Xinyuan-LilyGO/T-FPGA/dimensions/README.MD

# [PCB 3D](./pcb3d/FPGA-CORE.7z)



# [CORE SIZE](./dxf/FPGA-CORE.dwg)
