Xinyuan-LilyGO/T-FPGA/example/FPGA/i2c-slave/impl/gwsynthesis/i2c-slave_syn_resource.html

# Hierarchy Module Resource

MODULE NAME | REG NUMBER | ALU NUMBER | LUT NUMBER | DSP NUMBER | BSRAM NUMBER | SSRAM NUMBER
i2c (D:/File/Micky/Github/T-FPGA/example/FPGA/i2c-slave/i2c-slave/src/i2c.v) | - | - | 3 | - | - | -
|--slave (D:/File/Micky/Github/T-FPGA/example/FPGA/i2c-slave/i2c-slave/src/i2c.v) | 19 | - | 31 | - | - | -
