Xinyuan-LilyGO/T-FPGA/example/FPGA/spi-blink/impl/gwsynthesis/spi-blink_syn_resource.html

# Hierarchy Module Resource

MODULE NAME | REG NUMBER | ALU NUMBER | LUT NUMBER | DSP NUMBER | BSRAM NUMBER | SSRAM NUMBER
spi_top (D:/File/Micky/Github/T-FPGA/example/FPGA/spi-blink/src/spi-top.v) | 9 | 7 | 3 | - | - | -
|--osc (D:/File/Micky/Github/T-FPGA/example/FPGA/spi-blink/src/spi-top.v) | - | - | - | - | - | -
|--pll (D:/File/Micky/Github/T-FPGA/example/FPGA/spi-blink/src/spi-top.v) | - | - | - | - | - | -
|--spi_slaver1 (D:/File/Micky/Github/T-FPGA/example/FPGA/spi-blink/src/spi-top.v) | 28 | - | 24 | - | - | -
