Xinyuan-LilyGO/T-FPGA/image/6.png

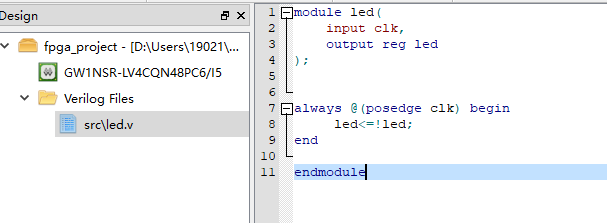
image/6.png
