Xinyuan-LilyGO/T-FPGA/(list of files, cad)

Other CAD files:
dimensions/dxf/FPGA-CORE.dwg
