Xinyuan-LilyGO/T-FPGA/(threads)

Thread 4 (2023-09-06):

Buttons incorrectly labled?

Ebiroll, 2023-09-06:
I tried to follow the instruction for the led program, but I used GOWIN version 1.9.8.11
I could not get the program to work properly so I flashed the precompiled turn_on_power S3 program. (from zip file)

I did this as I was not able to compile the S3 program with platform IO https://github.com/platformio/platform-espressif32/tags

Now it seems to work with lots of random blinking, (as expected)

However the GPIO0 button works but not the IOT13B button.
I also think I was able to set S3 into boot mode with the IOT13B  that is on the bottom to the right.
Is the buttons labeled incorrectly? Could you provide the correct labels of the 4 buttons?

Ebiroll, 2023-09-06:
Yes, the buttons are incorrectly labeled, https://github.com/Xinyuan-LilyGO/T-FPGA

Closed 2023-09-06.

Thread 6 (2023-10-31):

M.2 (Key B) common pinout incompatibility?

vrbadev, 2023-10-31:
From the M.2 Key B interface pinout in the schematic, I assume the interface is not used [in compliance with the M.2 interfaces](https://www.congatec.com/fileadmin/user_upload/Documents/Application_Notes/AN43_M.2_Pinout_Descriptions_and_Reference_Designs.pdf) common on motherboards.
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
Is my understanding correct that the board, in fact, can't be used in the common M.2 slot?

Thread 7 (2024-03-17):

Pin Voltage

carlosgblos, 2024-03-17:
I'm usinng the T-FPGA with the expansion kit. The PMODs are strange related to the voltage. The P6 and P8 on the VCC only provides 1.8V, the P3 and P5 I have 0V, even using the pins from that bank.

I already changed the ESP32 code to provide 3.3V to the banks, and still cannot get the proper voltage.

What am I doing wrong ?

Thread 9 (2024-09-21):

Unable to program FPGA on Linux Mint

ChrisJones79, 2024-09-21:
I read through the README and was able to upload the 'turn_on_power' project to the ESP32. I see the LEDs behaving appropriately and saw that the terminal in platformio reported a successful programming. Now, I have opened the Gowin IDE and all has compiled (it was already) and the programmer opens, as expected.

Here is the log from the programmer, while trying to upload to the FPGA. I do have the USB-C connected to the FPGA-JTAG port, too.

```
Info:	Cable found:  Gowin USB Cable(GWU2X)/0/17/null (USB location:17)
Info:	Cost 0.02 second(s)
:
Info:	Cable found:  Gowin USB Cable(GWU2X)/0/17/null (USB location:17)
Info:	Cost 0.01 second(s)
:
Info:	Target Cable: Gowin USB Cable(GWU2X)/0/17/null@1.33 MHz
Info:	Target Device: GW1NSR-4C(0x0100981B)
Info:	Operation "SRAM Program" for device#1...
Error:	Cable open failed.
Info:	Cost 0.0 second(s)
:
Info:	Target Cable: Gowin USB Cable(GWU2X)/0/17/null@1.33 MHz
Info:	Target Device: GW1NSR-4C(0x0100981B)
Info:	Operation "SRAM Program" for device#1...
Error:	Cable open failed.
Info:	Cost 0.0 second(s)
:
Info:	Scanning!
Info:	Target Cable: Gowin USB Cable(GWU2X)/0/17/null@1.33 MHz
Error:	Cable open failed.
Error:	No Gowin devices found!
Info:	Cost 0.02 second(s)
```

Also:
```
$ lsusb
Bus 001 Device 037: ID 33aa:0120 GOWINSEMI GWU2X
```

and plugging in while udev monitoring:

```
$ udevadm monitor
KERNEL[675634.337777] add      /devices/pci0000:00/0000:00:14.0/usb1/1-2 (usb)
KERNEL[675634.339741] add      /devices/pci0000:00/0000:00:14.0/usb1/1-2/1-2:1.0 (usb)
KERNEL[675634.339944] bind     /devices/pci0000:00/0000:00:14.0/usb1/1-2 (usb)
UDEV  [675634.376606] add      /devices/pci0000:00/0000:00:14.0/usb1/1-2 (usb)
UDEV  [675634.378558] add      /devices/pci0000:00/0000:00:14.0/usb1/1-2/1-2:1.0 (usb)
UDEV  [675634.383025] bind     /devices/pci0000:00/0000:00:14.0/usb1/1-2 (usb)

```

I don't have any `udev` rules added for the T-FPGA, and I didn't see anywhere in the repo where the rules would be.

Here's a screenshot from the programmer:
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

Any help? Thanks.

Thread 10 (2025-05-04):

ERROR  (CT1136) : Bank 3 vccio(1.8) is locked by other constraint or embedded port, conflicting BANK_VCCIO set by 'led_state_obuf' : IO_TYPE = LVCMOS33 in the same bank

juthi, 2025-05-04:
"led_state" is on BANK3. BANK3 on this FPGA device is also mated with HyperRam so VIO is fixed to 1v8.

Therefore,
IO_PORT "led_state" IO_TYPE=LVCMOS33 PULL_MODE=NONE DRIVE=8; // will raise an error with the latest toolchains from Gowin.

Fix:

IO_PORT "led_state" IO_TYPE=LVCMOS**_18_** PULL_MODE=NONE DRIVE=8;
