Xinyuan-LilyGO/T-FPGA/schematic/T-FPGA-V1.0 CORE.pdf

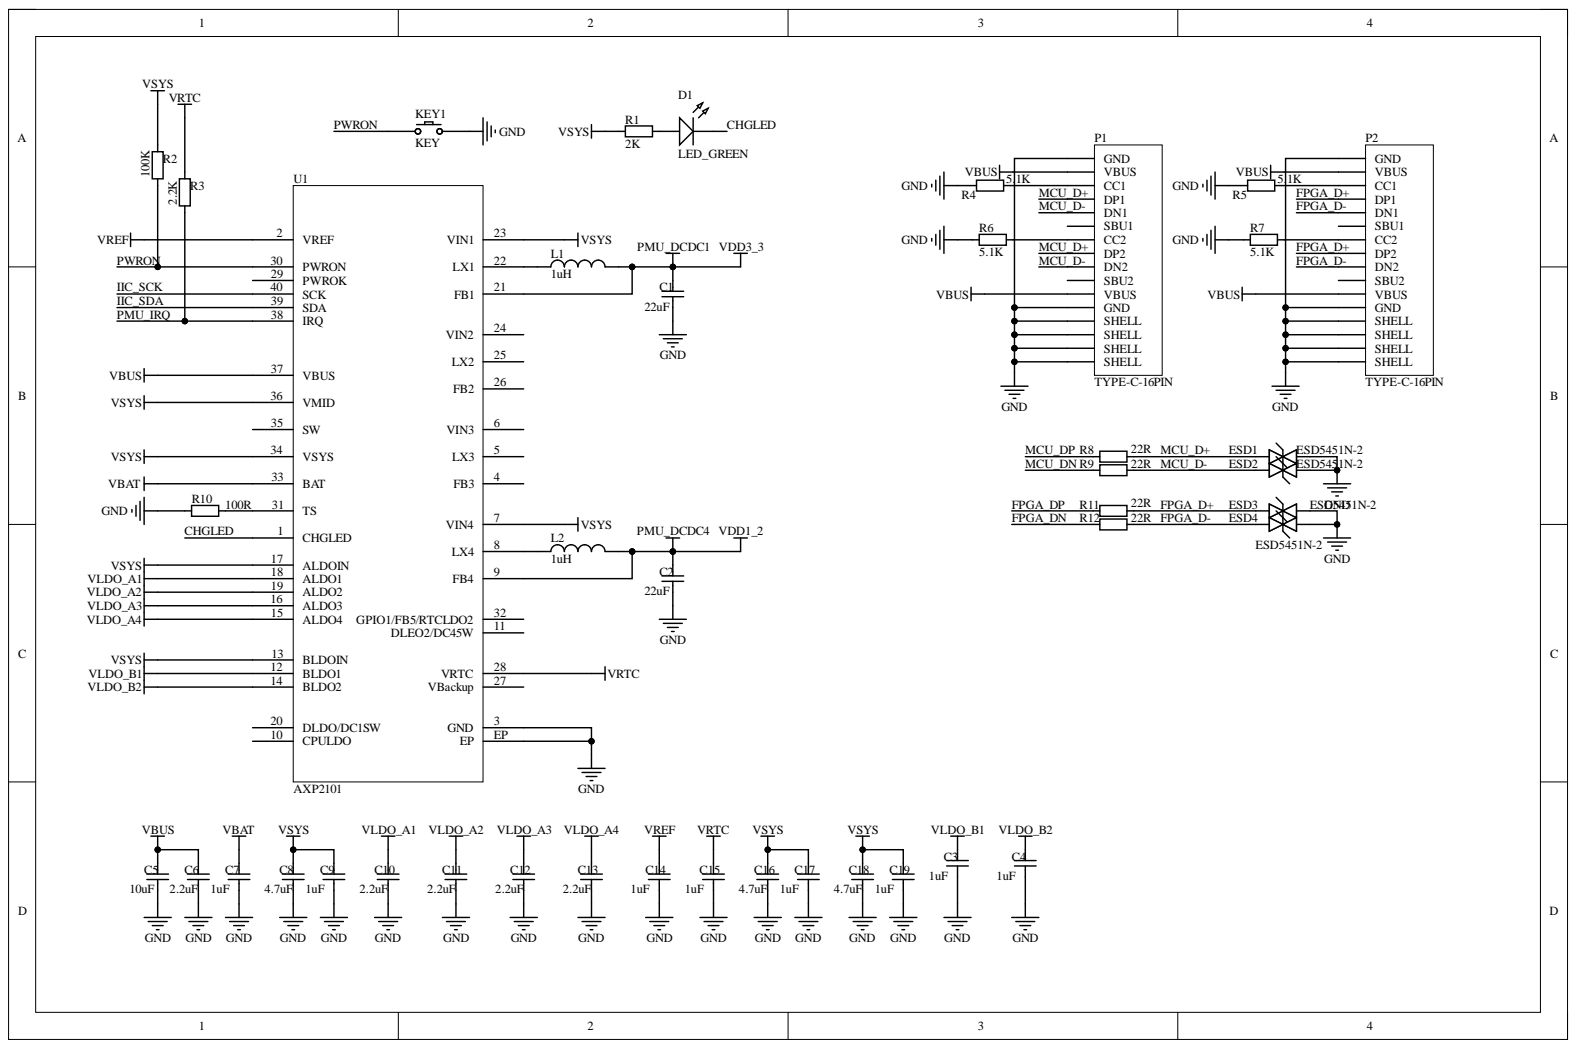
[picture p21: page 1]

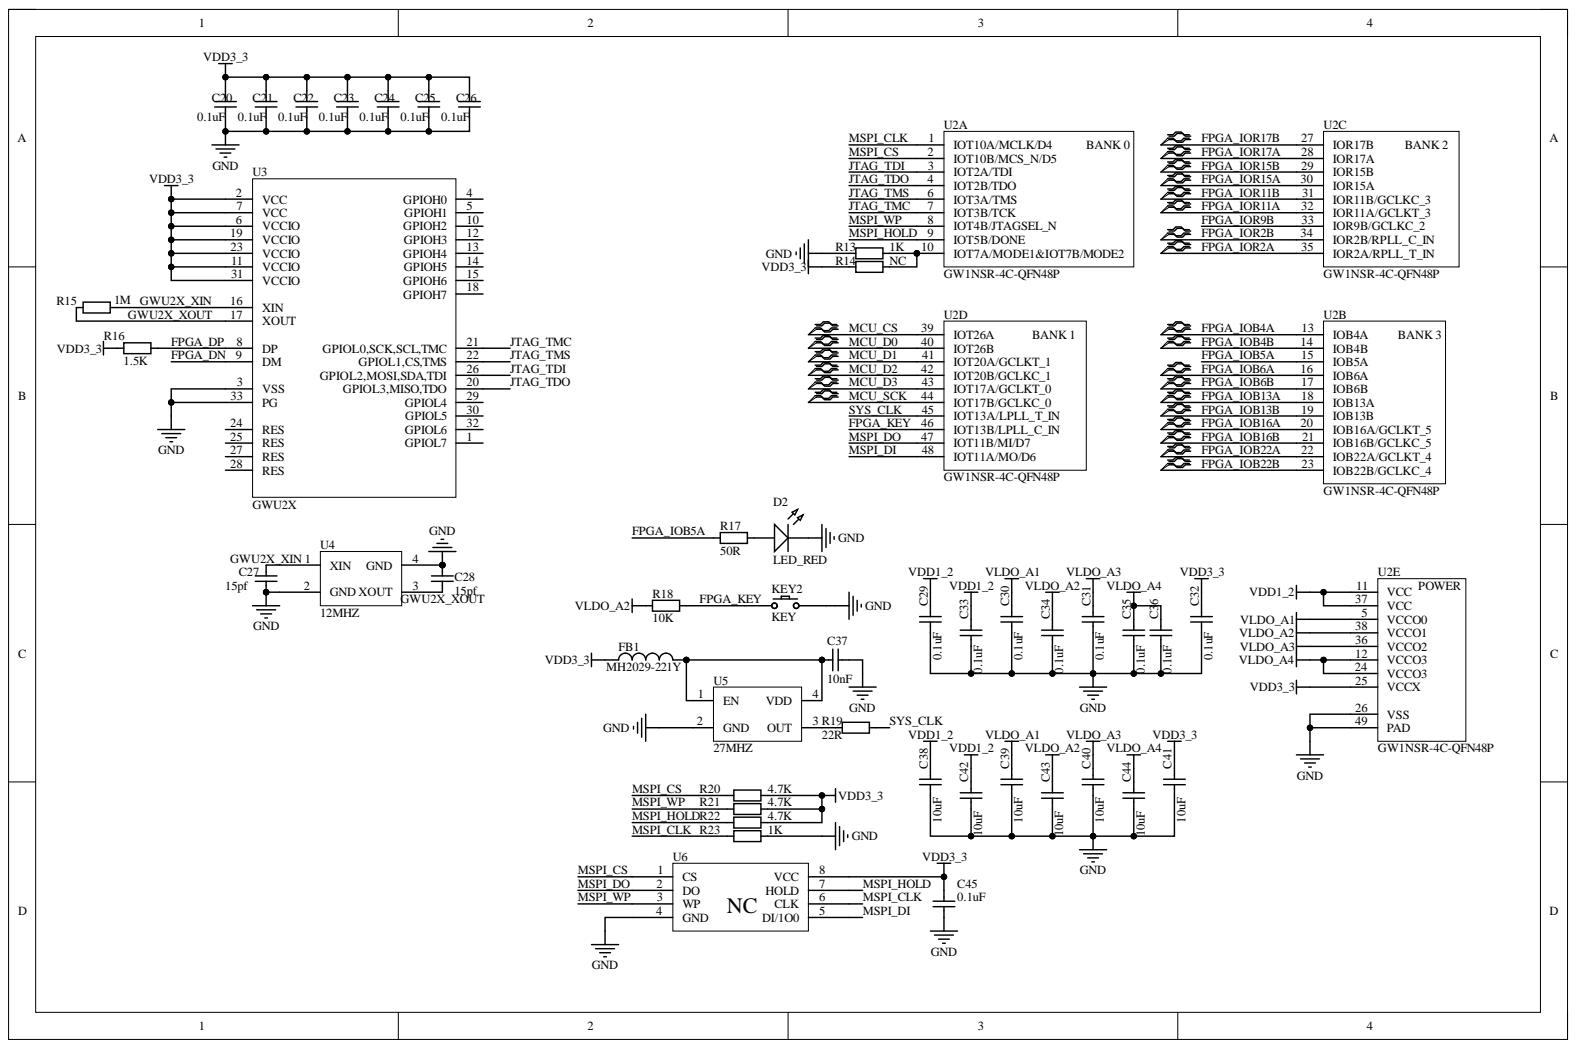
[picture p22: page 2]

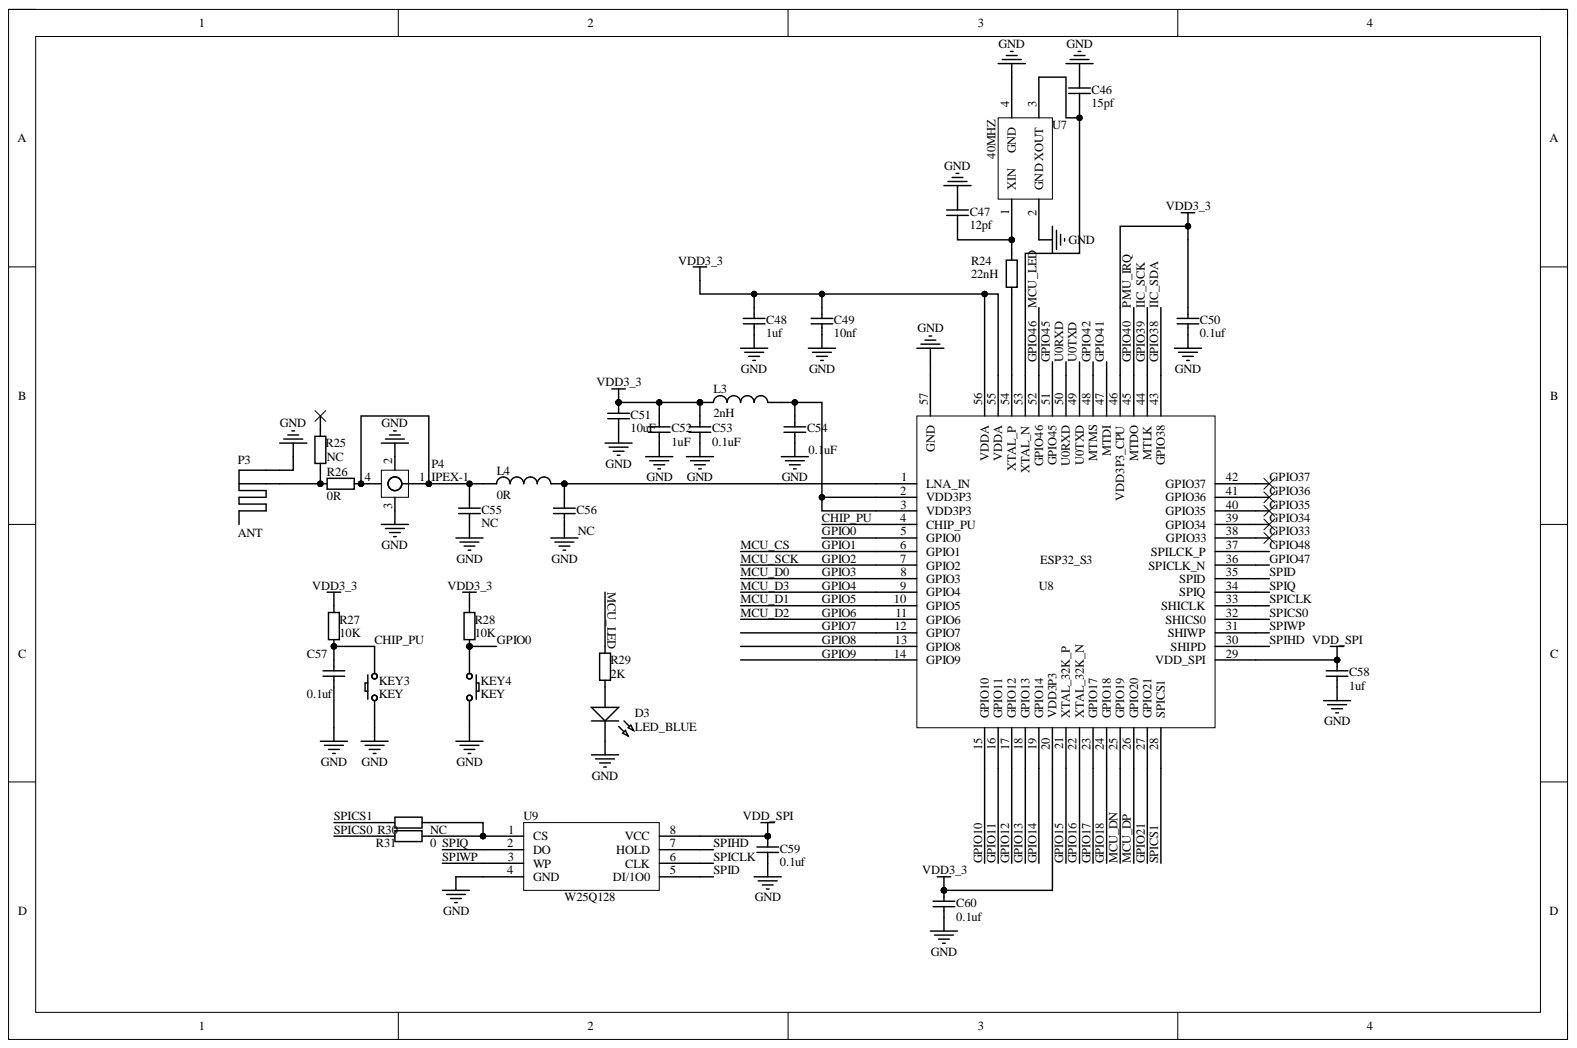
[picture p23: page 3]

GPIO38 43 MTLK 44 MTDO 45 VDD3P3_CPU 46 MTDI 47 MTMS 48 U0TXD 49 U0RXD 50 GPIO45 51 GPIO46 52 XTAL_N 53 XTAL_P 54 VDDA 55 VDDA 56

SPICS1 28 VDD_SPI 29 SHIPD 30 SHIWP 31 SHICS0 32 SHICLK 33 SPIQ 34 SPID 35 SPICLK_N 36 SPILCK_P 37 GPIO33 38 GPIO34 39 GPIO35 40

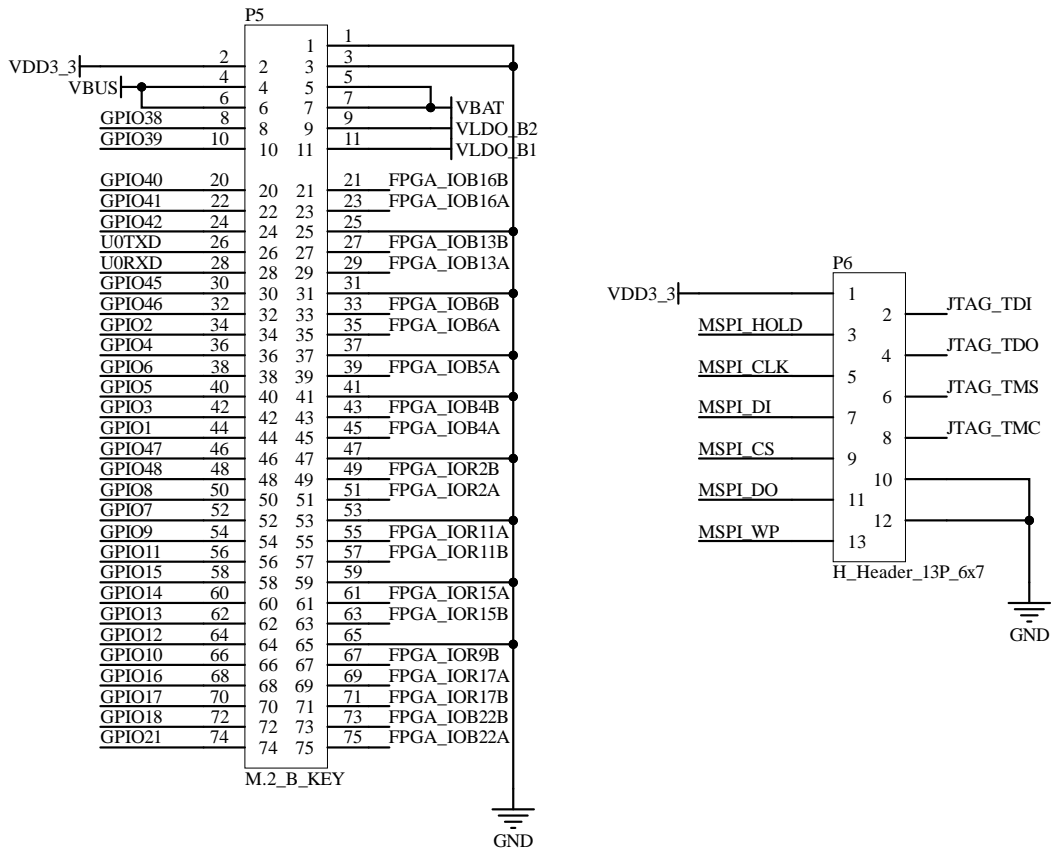
[picture p24: page 4]
