Xinyuan-LilyGO/T-FPGA/schematic/T-FPGA-MAIN.pdf

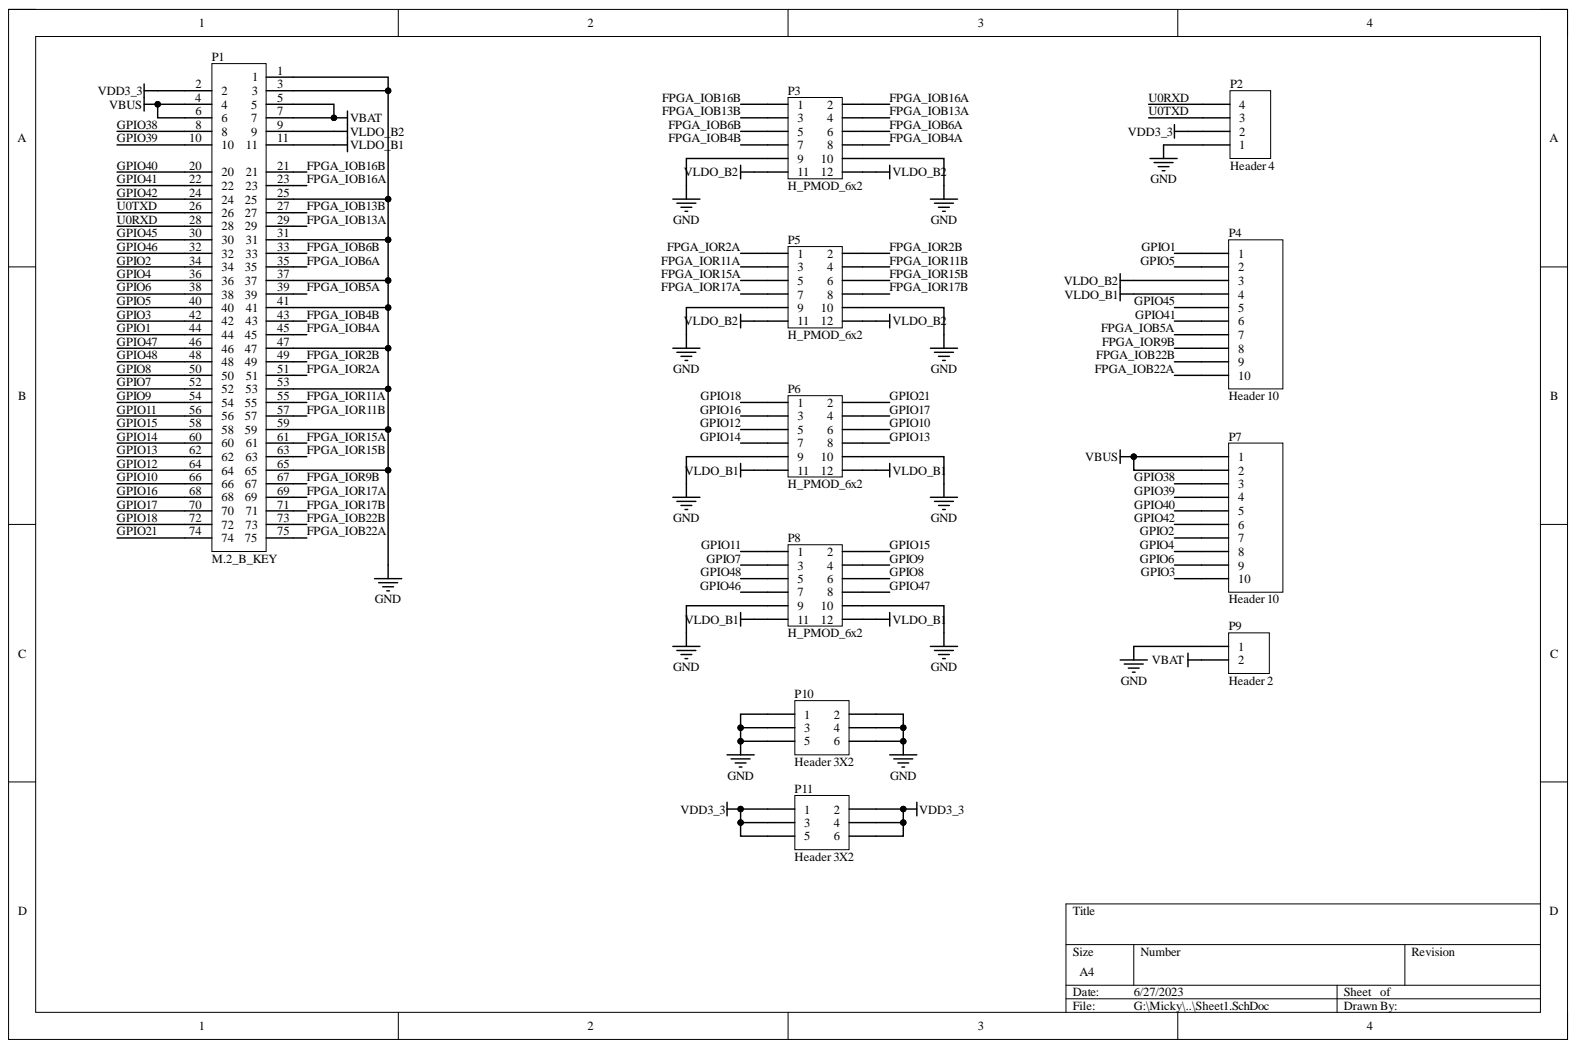
[picture p25: page 1]

Siz e A4 | Numb e r | R evisio n

Da te : 6/27/202 3 | She et of
File : G:\Micky\. .\She et1 . S c hD o c | Dr awn B y :
