Xinyuan-LilyGO/T-FPGA/(list of files, drawings)

Other design files:
PCB/FPGA_MAIN.PcbDoc
PCB/FPGA_MAIN.PrjPcb
PCB/Sheet1.SchDoc
