Xinyuan-LilyGO/T-FPGA/example/ESP32-S3/i2c_blink/pins_config.h

#pragma once

#define PIN_BTN      0

#define PIN_IIC_SDA  38
#define PIN_IIC_SCL  39
#define PIN_PMU_IRQ  40

#define PIN_LED      46

#define PIN_FPGA_CS  1
#define PIN_FPGA_SCK 2
#define PIN_FPGA_D0  3
#define PIN_FPGA_D1  5
#define PIN_FPGA_D2  6
#define PIN_FPGA_D3  4
