Xinyuan-LilyGO/T-FPGA/example/FPGA/spi-blink/src/gowin_osc/gowin_osc.v

//Copyright (C)2014-2021 Gowin Semiconductor Corporation.
//All rights reserved.
//File Title: IP file
//GOWIN Version: V1.9.8.01
//Part Number: GW1NSR-LV4CQN48PC6/I5
//Device: GW1NSR-4C
//Created Time: Thu Feb 23 16:29:02 2023

module Gowin_OSC (oscout, oscen);

output oscout;
input oscen;

OSCZ osc_inst (
    .OSCOUT(oscout),
    .OSCEN(oscen)
);

defparam osc_inst.FREQ_DIV = 10;

endmodule //Gowin_OSC
