Xinyuan-LilyGO/T-FPGA/example/FPGA/spi-blink/src/gowin_osc/gowin_osc_tmp.v

//Copyright (C)2014-2021 Gowin Semiconductor Corporation.
//All rights reserved.
//File Title: Template file for instantiation
//GOWIN Version: V1.9.8.01
//Part Number: GW1NSR-LV4CQN48PC6/I5
//Device: GW1NSR-4C
//Created Time: Thu Feb 23 16:29:02 2023

//Change the instance name and port connections to the signal names
//--------Copy here to design--------

    Gowin_OSC your_instance_name(
        .oscout(oscout_o), //output oscout
        .oscen(oscen_i) //input oscen
    );

//--------Copy end-------------------
