Xinyuan-LilyGO/T-FPGA/(commit log)

2023-06-27 T-FPGA-MAIN Schematic Upload
2023-06-28 Added Shiled PCB
    [FPGA_MAIN.PcbDoc, FPGA_MAIN.PrjPcb, Sheet1.SchDoc]
2025-07-08 Update spi examples
2025-07-11 Fixed spi-blink
2025-11-11 Fixed led example
2025-11-17 Update FPGA and ESP using SPI communication example
2026-05-15 Update voltage notes
